Lujham1/ASIC_UCC/(commit log)

2026-10-24 Proyecto Integrador ASIC UCC: estructura inicial con PDK IHP SG13G2 fijado
    - PDK IHP-Open-PDK como submódulo en pdk/ihp-sg13g2, rama dev,
    commit fijado cb743f75 (2026-10-23).
    - SOURCEME, xschemrc común y scripts/setup.sh para usar siempre el
    PDK fijado dentro del contenedor IIC-OSIC-TOOLS (compila los modelos
    OSDI, registra stdcells en KLayout, autocarga del entorno).
    - .gitattributes (LF), verificación automática de PRs, plantilla de PR
    y CODEOWNERS.
    - Diseños Enfoque_A (Bandgap) y Enfoque_B (ASIC_TOP) con rutas
    portables.
    Claude-Session: https://claude.ai/code/session_01X1ijhciB1VhTENzsrYhu6B
    [ASIC_TOP.sch, Bandgap_ISSCC5.sch, Ll.sch]
2026-10-25 feat(enfoque_b): celdas con simbolos y ASIC_TOP jerarquico
    [ASIC_TOP.sch, ASIC_TOP_plano.sch, deco_2a4.sch, espejo_poto_sel.sch, osc_relax.sch, sel_c_hum.sch, sel_r_ntc.sch, vi_ph_sel.sch]
2026-10-25 feat(enfoque_a): bandgap jerarquico listo para layout y LVS + guia de layout
    [Bandgap_ISSCC5_plano.sch, Ll.sch, bandgap.sch, bjt_pair.sch, ctat_div.sch, fase_gen.sch, ptat_stage.sch, sc_bias.sch]
